jmsaavedra/gadgiteration/README.md

gadgiteration
=============

Hardware and firmware for the gadgiteration noisemaker v2.0

http://gadgiteration.org
