jmsaavedra/gadgiteration/v4.0/README.md

gadgIteration hardware v3.0
=============

ATmega32u4 Implementation of the Noisemaker!

###digital pinouts###

* D2 - Mode Button
* D5 - on-board LEDs. HIGH/LOW to flip LED1/LED2
* D6 - Neopixel Connection
* D7 - Range Button
* D8 - Audio out. NPN amplifier to speaker.

###analog pinouts###

* A0 - Standard Alligator In
* A1 - Human Circuit In
* A2 - SENSOR 1. 10k pull-down.
* A3 - SENSOR 2. 10k pull-down.
* A4 - SENSOR 3. VCC - SENS - GND.

###known bugs###
