jmsaavedra/gadgiteration/v4.0/eagle/noisemaker_4-0_BOM.xlsx

Part | Value | Link | Device | Package | Description | PROD_ID | VALUE
ATMEGA32U4 | ATMEGA32U4 | http://www.mouser.com/Search/ProductDetail.aspx | ATMEGA32U4TQFP | SPARKFUN-DIGITALIC_TQFP44 | Atmel 44-pin 8-bit Microcontroller with 32KBytes of ISP Flash and USB Controller | https://www.sparkfun.com/products/11181
POLE1 | alligator clip holes | https://www.adafruit.com/products/321 | M01ALLIGATOR-3MM | 1X01_ALLIGATOR_3MM | Header 1
LED1 | WS2812B3535 | http://www.mouser.com/ProductDetail/Seeed-Studio/110990053/?qs=sGAEpiMZZMtzPgOfznR9QTO1l8g3oIgjmGvsDAmgJrQ%3d | WS2812B3535 | LED3535 |  | https://www.adafruit.com/products/1655
C1, C3 | 0.1uF | http://www.mouser.com/ProductDetail/Vishay-Vitramon/VJ1206Y104KXJPW1BC/ | CAP1206 | 1206 | Capacitor
C2, C4 | 22pF | http://www.mouser.com/ProductDetail/Vishay-Vitramon/VJ0603A220JXACW1BC/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 | CAP0603-CAP | 0603-CAP | Capacitor
C5, C6, C9 | 1uF | https://www.mouser.com/Search/ProductDetail.aspx | CAP1206 | 1206 | Capacitor
C7, C8 | 10uF | http://www.mouser.com/Search/ProductDetail.aspx | CAP_POL3528-KIT | EIA3528-KIT | Capacitor Polarized
D4 |  | http://www.mouser.com/ProductDetail/Vishay-Semiconductors/BAS16WS-E3-08/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 | DIODESOD | SOD-323 | Diode
F1 | 500mA | https://www.mouser.com/Search/ProductDetail.aspx | PTCSMD | PTC-1206 | Resettable Fuse PTC
NPN |  | https://www.mouser.com/Search/ProductDetail.aspx | TRANSISTOR_NPNSOT23-3 | SOT23-3 | Generic NPN BJT. MMBT2222 is the common NPN we use. Double check against datasheet- not all devices are the same!
PWR | Red LED | http://www.mouser.com/ProductDetail/Kingbright/APT3216EC/?qs=sGAEpiMZZMseGfSY3csMkeytxqHAv00AIWduoh668qk%3d | LEDCHIPLED_1206 | CHIPLED_1206 | LED
PWRJACK | 2.1MMJACKTHM | https://www.mouser.com/Search/ProductDetail.aspx | 2.1MMJACKTHM | PJ-102A | 2.1mm x 5.5mm THM DC jack with internal switch. Digikey part #PJ-102A, 4UCON part #05537
R1, R11 | 1K | https://www.mouser.com/Search/ProductDetail.aspx | RESISTOR1206 | 1206 | Resistor
R2, R10, R13, R14 | 10K | https://www.mouser.com/Search/ProductDetail.aspx | RESISTOR1206 | 1206 | Resistor
R3, R8 | 1M | https://www.mouser.com/Search/ProductDetail.aspx | RESISTOR1206 | 1206 | Resistor
R4, R5 | 22 | https://www.mouser.com/Search/ProductDetail.aspx | RESISTOR1206 | 1206 | Resistor
R6, R7 | 330 | https://www.mouser.com/Search/ProductDetail.aspx | RESISTOR1206 | 1206 | Resistor
R9 | 22k | https://www.mouser.com/Search/ProductDetail.aspx | RESISTOR1206 | 1206 | Resistor
R12 | 2M | https://www.mouser.com/Search/ProductDetail.aspx | RESISTOR1206 | 1206 | Resistor
RX | Green LED | http://www.mouser.com/ProductDetail/OSRAM-Opto-Semiconductors/LG-N971-KN-1/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 | LEDCHIPLED_1206 | CHIPLED_1206 | LED
TX | Yellow LED | https://www.mouser.com/Search/ProductDetail.aspx | LEDCHIPLED_1206 | CHIPLED_1206 | LED
USB | USB-CON-5PIN-105017-0001 | http://www.mouser.com/ProductDetail/Molex/105017-0001/?qs=hlXxxvYE36k7QcsR97GUKA%3D%3D | USB-CON-5PIN-105017-0001 | USB-MICRO-MOLEX-105017-0001 | Molex Micro USB 105017-0001
MODE | MODE BUTTON | https://www.mouser.com/Search/ProductDetail.aspx | 10-XX | B3F-10XX | OMRON SWITCH
VOL | VOLUME POTENTIOMETER | https://www.mouser.com/Search/ProductDetail.aspx | POT | ALPS_POT |  | RES-09177
VREG | MIC5219 5V | http://www.mouser.com/ProductDetail/Microchip-Technology-Micrel/MIC5219-50YM5-TR/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 | V_REG_MIC52195V | SOT23-5 | V_REG MIC5219 | VREG-10107 | MIC5219 5V
XTAL | 16MHz | https://www.mouser.com/Search/ProductDetail.aspx | CRYSTAL5X3 | CRYSTAL-SMD-5X3 | Crystals
