jmsaavedra/gadgiteration/v4.0/eagle/noisemaker_4-0.pdf

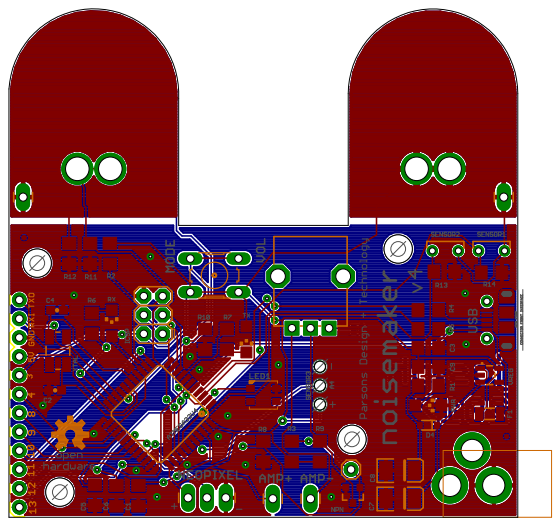
[picture p1: page 1]
