jmsaavedra/gadgiteration/v5.0/eagle/noisemaker_5-0.brd

## EAGLE design v5.0/eagle/noisemaker_5-0.brd (2017-06-26)

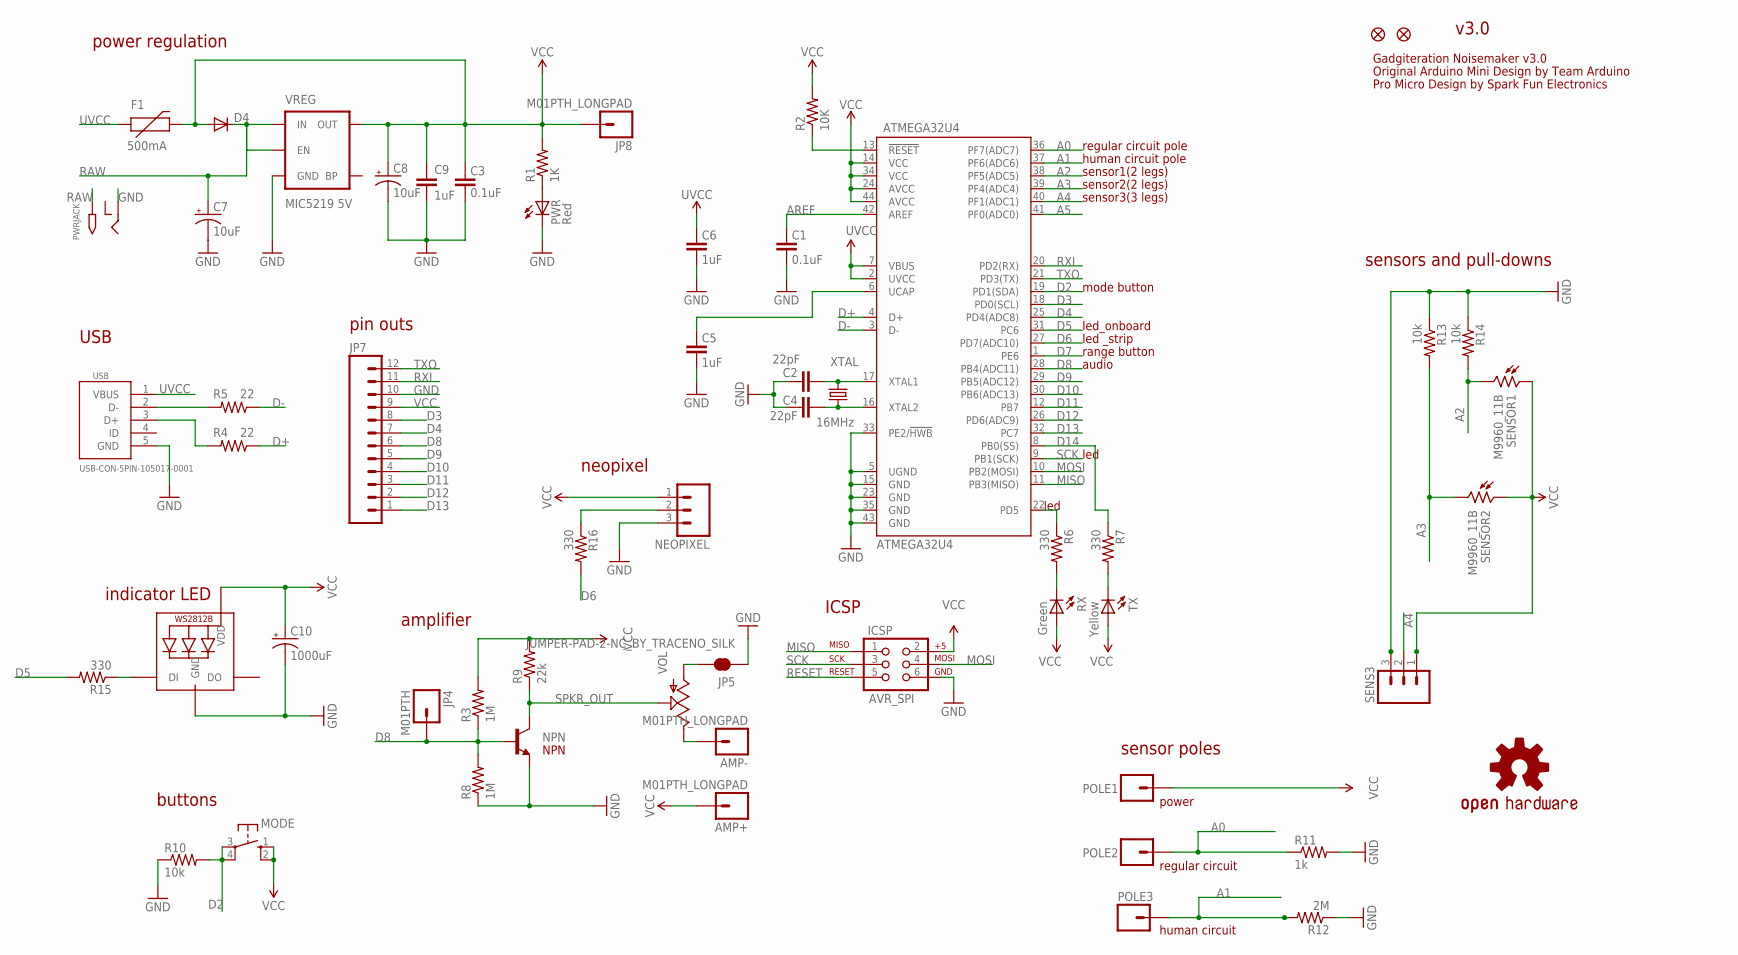
[picture p2: schematic noisemaker_5-0.sch]

Parts:
AMP+: M01PTH_LONGPAD; 1X01_LONGPAD
AMP-: M01PTH_LONGPAD; 1X01_LONGPAD
ATMEGA32U4: ATMEGA32U4; SPARKFUN-DIGITALIC_TQFP44
C1, C3: 0.1uF; 1206
C2, C4: 22pF; 0603-CAP
C5, C6, C9: 1uF; 1206
C7, C8: 10uF; EIA3528-KIT
C10: 1000uF; EIA3528-KIT
D4: DIODESOD; SOD-323
F1: 500mA; PTC-1206
ICSP: AVR_SPI; 2X3
JP1, JP2: FIDUCIALUFIDUCIAL; MICRO-FIDUCIAL
JP4: M01PTH; 1X01
JP5: JUMPER-PAD-2-NC_BY_TRACENO_SILK; PAD-JUMPER-2-NC_BY_TRACE_NO_SILK
JP7: M12PTH; 1X12
JP8: M01PTH_LONGPAD; 1X01_LONGPAD
LED1: WS2812B3535; LED3535
LOGO1: OSHW-LOGOM; OSHW-LOGO-M
MODE: 10-XX; B3F-10XX
NEOPIXEL: M03LONGPADS; 1X03_LONGPADS
NPN: TRANSISTOR_NPNSOT23-3; SOT23-3
POLE1, POLE2: M01ALLIGATOR-3MM; 1X01_ALLIGATOR_3MM
POLE3: M01PTH_LONGPAD; 1X01_LONGPAD
PWR: Red; CHIPLED_1206
PWRJACK: 2.1MMJACKTHM; PJ-102A
R1: 1K; 1206
R2: 10K; 1206
R3, R8: 1M; 1206
R4, R5: 22; 1206
R6, R7, R15, R16: 330; 1206
R9: 22k; 1206
R10, R13, R14: 10k; 1206
R11: 1k; 1206
R12: 2M; 1206
RX: Green; CHIPLED_1206
SENS3: M03POGO_PIN_HOLES_ONLY; 1X03_PP_HOLES_ONLY
SENSOR1, SENSOR2: M9960_11B; M9960
TX: Yellow; CHIPLED_1206
USB: USB-CON-5PIN-105017-0001; USB-MICRO-MOLEX-105017-0001
VOL: POT; ALPS_POT
VREG: MIC5219 5V; SOT23-5
XTAL: 16MHz; CRYSTAL-SMD-5X3

Connections:
A0: ATMEGA32U4.36 (PF7(ADC7)), POLE2.1@0, POLE2.1@2, R11.1
A1: ATMEGA32U4.37 (PF6(ADC6)), POLE3.1, R12.2
A2: ATMEGA32U4.38 (PF5(ADC5)), R14.2, SENSOR1.2
A3: ATMEGA32U4.39 (PF4(ADC4)), R13.2, SENSOR2.2
A4: ATMEGA32U4.40 (PF1(ADC1)), SENS3.2
A5: ATMEGA32U4.41 (PF0(ADC0))
AREF: ATMEGA32U4.42 (AREF), C1.2
D2: ATMEGA32U4.19 (PD1(SDA)), MODE.3, MODE.4 (P1), R10.2
D3: ATMEGA32U4.18 (PD0(SCL)), JP7.8
D4: ATMEGA32U4.25 (PD4(ADC8)), JP7.7
D5: ATMEGA32U4.31 (PC6), R15.2
D6: ATMEGA32U4.27 (PD7(ADC10)), R16.2
D7: ATMEGA32U4.1 (PE6)
D8: ATMEGA32U4.28 (PB4(ADC11)), JP4.1, JP7.6, NPN.1 (B), R3.1, R8.2
D9: ATMEGA32U4.29 (PB5(ADC12)), JP7.5
D10: ATMEGA32U4.30 (PB6(ADC13)), JP7.4
D11: ATMEGA32U4.12 (PB7), JP7.3
D12: ATMEGA32U4.26 (PD6(ADC9)), JP7.2
D13: ATMEGA32U4.32 (PC7), JP7.1
D14: ATMEGA32U4.8 (PB0(SS)), R7.1
D+: ATMEGA32U4.4 (D+), R4.1
D-: ATMEGA32U4.3 (D-), R5.1
GND: ATMEGA32U4.5 (UGND), ATMEGA32U4.15 (GND), ATMEGA32U4.23 (GND), ATMEGA32U4.33 (PE2/!HWB), ATMEGA32U4.35 (GND), ATMEGA32U4.43 (GND), C1.1, C2.2, C3.1, C4.2, C5.1, C6.1, C7.C (-), C8.C (-), C9.2, C10.C (-), ICSP.6, JP5.1, JP7.10, LED1.4 (GND), NEOPIXEL.3, NPN.2 (E), PWR.C, PWRJACK.RING, R8.1, R10.1, R11.2, R12.1, R13.1, R14.1, SENS3.3, USB.5 (GND), VREG.2 (GND)
MISO: ATMEGA32U4.11 (PB3(MISO)), ICSP.1
MOSI: ATMEGA32U4.10 (PB2(MOSI)), ICSP.4
unnamed: ATMEGA32U4.16 (XTAL2), C4.1, XTAL.1
unnamed: ATMEGA32U4.17 (XTAL1), C2.1, XTAL.3 (2)
unnamed: AMP-.1, VOL.P$1 (E)
unnamed: ATMEGA32U4.6 (UCAP), C5.2
unnamed: R7.2, TX.C
unnamed: JP5.2, VOL.P$3 (A)
unnamed: R6.2, RX.C
unnamed: LED1.1 (DI), R15.1
unnamed: NEOPIXEL.2, R16.1
unnamed: PWR.A, R1.1
unnamed: R4.2, USB.3 (D+)
unnamed: R5.2, USB.2 (D-)
RAW: C7.A (+), D4.1 (C), PWRJACK.TIP, VREG.1 (IN), VREG.3 (EN)
RESET: ATMEGA32U4.13 (!RESET), ICSP.5, R2.1
RXI: ATMEGA32U4.20 (PD2(RX)), JP7.11
SCK: ATMEGA32U4.9 (PB1(SCK)), ICSP.3
SPKR_OUT: NPN.3 (C), R9.1, VOL.P$2 (S)
TXLED: ATMEGA32U4.22 (PD5), R6.1
TXO: ATMEGA32U4.21 (PD3(TX)), JP7.12
UVCC: ATMEGA32U4.2 (UVCC), ATMEGA32U4.7 (VBUS), C6.2, F1.1, USB.1 (VBUS)
VCC: AMP+.1, ATMEGA32U4.14 (VCC), ATMEGA32U4.24 (AVCC), ATMEGA32U4.34 (VCC), ATMEGA32U4.44 (AVCC), C3.2, C8.A (+), C9.1, C10.A (+), D4.2 (A), F1.2, ICSP.2, JP7.9, JP8.1, LED1.2 (VDD), MODE.1 (S), MODE.2 (S1), NEOPIXEL.1, POLE1.1@0, POLE1.1@2, R1.2, R2.2, R3.2, R9.2, RX.A, SENS3.1, SENSOR1.1, SENSOR2.1, TX.A, VREG.5 (OUT)

Notes on the sheet:
Original Arduino Mini Design by Team Arduino
Pro Micro Design by Spark Fun Electronics
v3.0
power regulation
pin outs
USB
NPN
amplifier
sensors and pull-downs
ICSP
buttons
sensor poles
human circuit
regular circuit
power
Gadgiteration Noisemaker v3.0
sensor3(3 legs)
sensor1(2 legs)
sensor2(2 legs)
human circuit pole
regular circuit pole
mode button
range button
audio
led_onboard
led
led _strip
neopixel
indicator LED

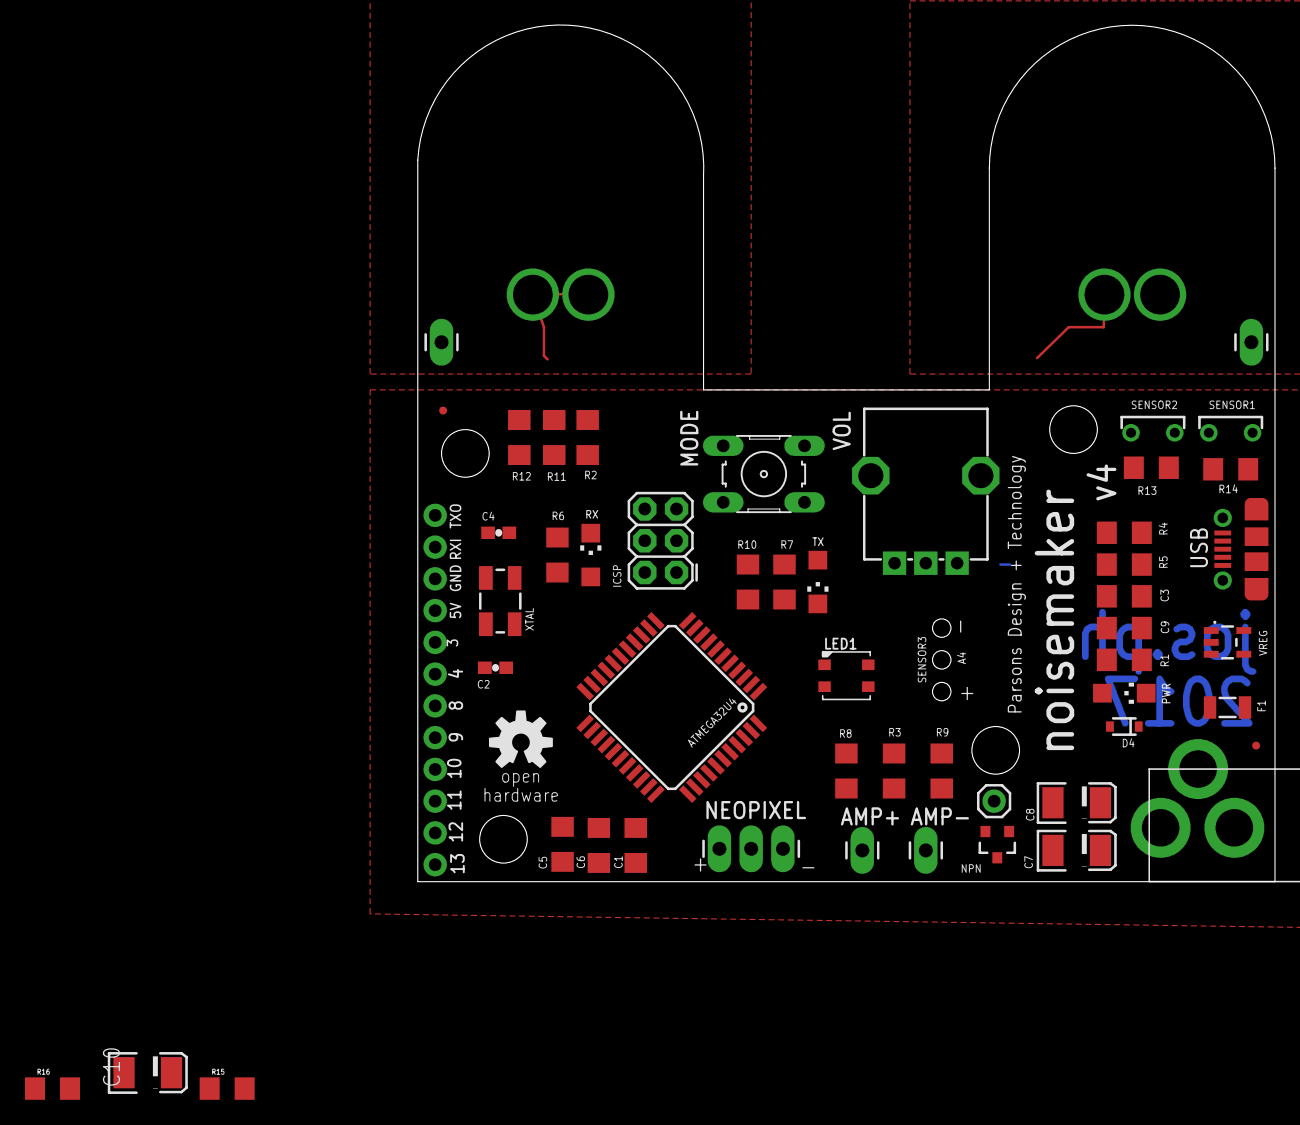
[picture p3: board noisemaker_5-0.brd from above]

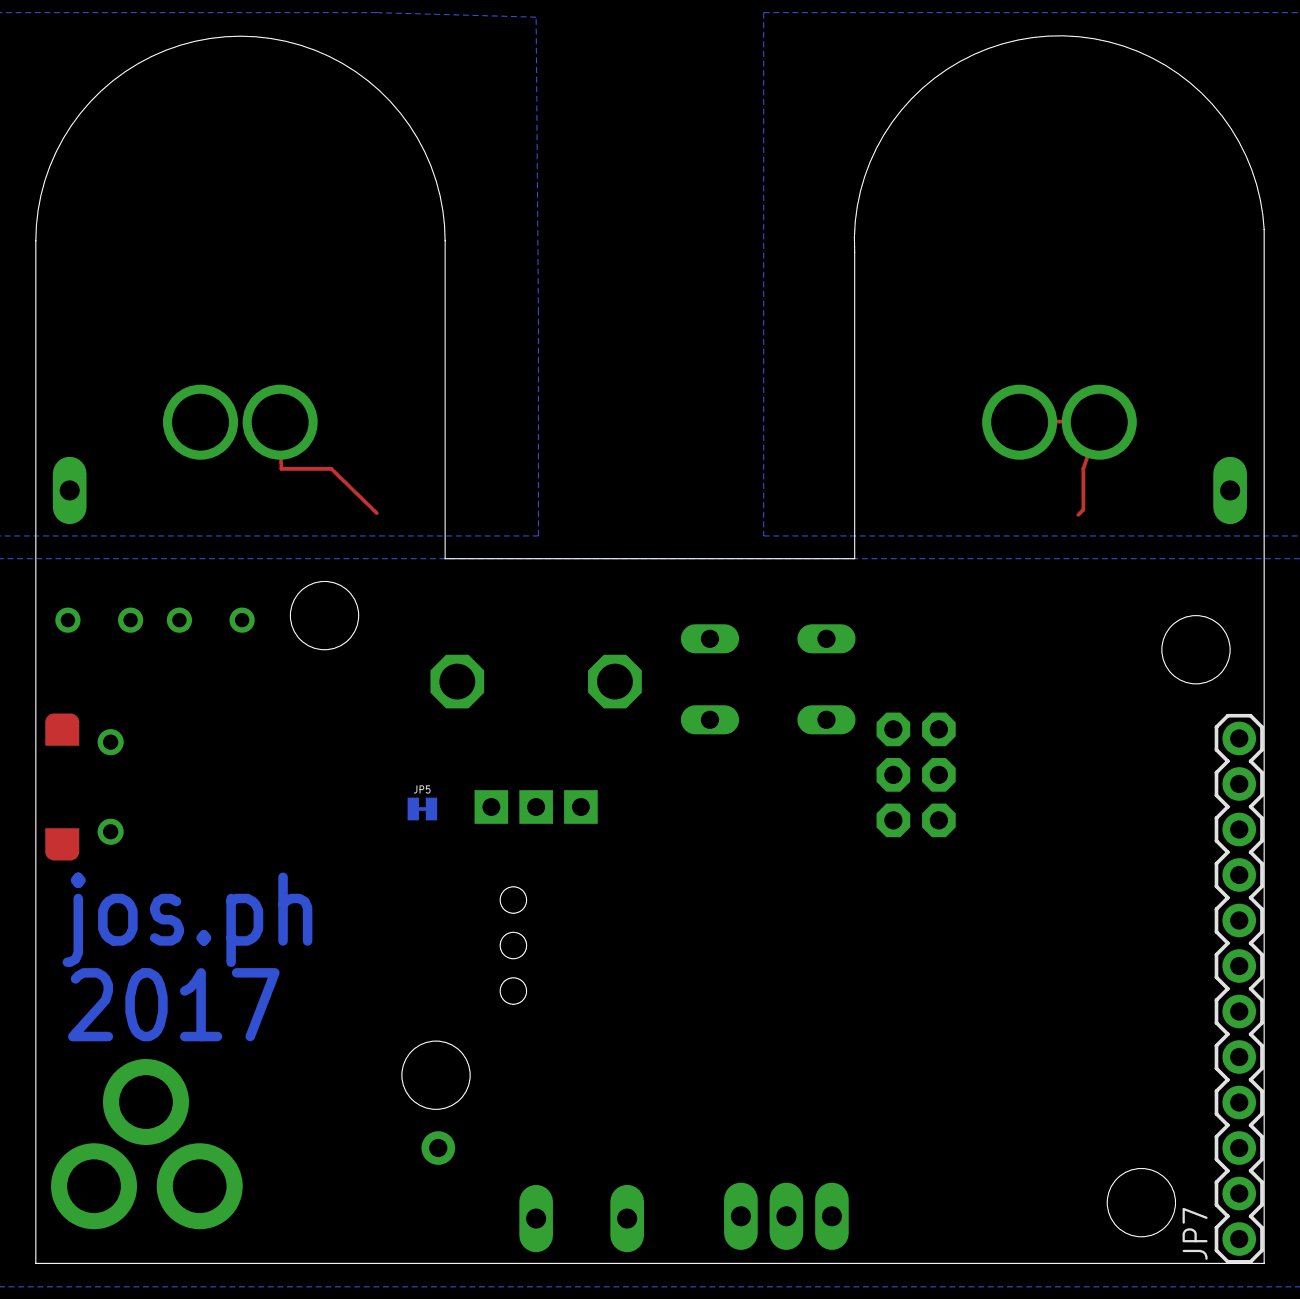
[picture p4: board noisemaker_5-0.brd from below]

Board: 2 copper layers, 68.6 x 68.5 mm, 57 parts (2 on the bottom side), 44 nets.
