jmsaavedra/gadgiteration/v2.0/eagle/gadgiteration_v20.brd

## EAGLE design v2.0/eagle/gadgiteration_v20.brd (2013-07-01, an earlier design)

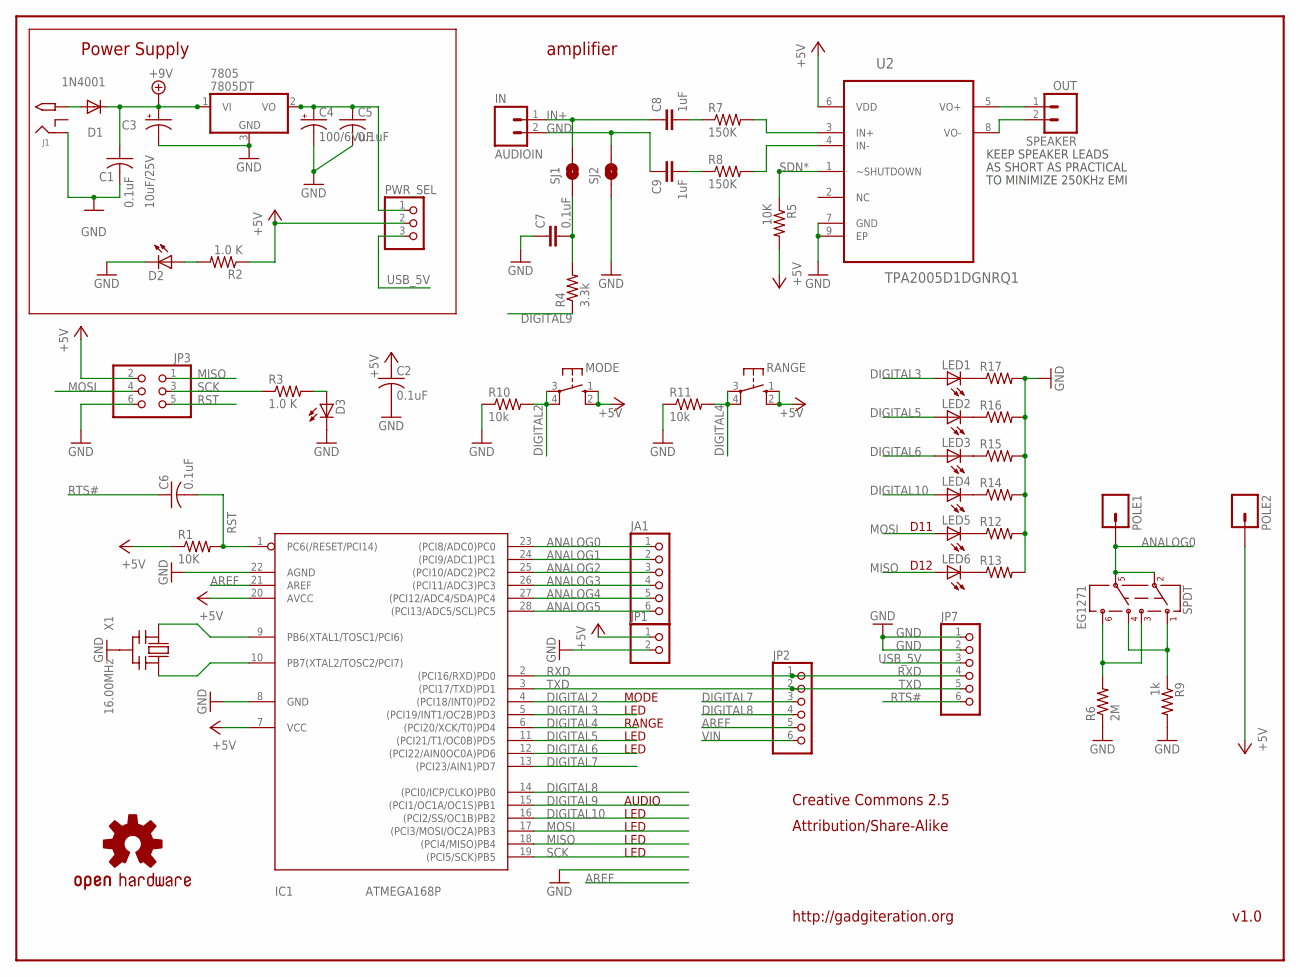
[picture p5: schematic gadgiteration_v20.sch]

Parts:
7805: 7805DT; TO252
AUDIOIN: IN; 1X02
C1, C2, C5, C6: 0.1uF; C025-025X050
C3: 10uF/25V; E2,5-6
C4: 100/6VuF; E2,5-6
C7: 0.1uF; CAP-PTH-SMALL-KIT
C8, C9: 1uF; 1206
D1: 1N4001; DIODE-1N4001
D2: LED3MM
D3: Green; LED3MM
IC1: ATMEGA168P; DIL28/3
J1: 2.1MMJACK; PJ-102A
JA1: PINHD-1X6CB; 1X06-CLEANBIG
JP1: PINHD-1X2CB; 1X02-CB
JP2: PINHD-1X6CB; 1X06-CLEANBIG
JP3: PINHD-2X3; 2X03
JP7: PINHD-1X6CLEAN; 1X06-CLEAN
LED1, LED2, LED3, LED4, LED5, LED6: LEDCHIPLED_1206; CHIPLED_1206
LOGO1: OSHW-LOGOM; OSHW-LOGO-M
MODE: 10-XX; B3F-10XX
POLE1, POLE2: M01PTH_LONGPAD; 1X01_LONGPAD
PWR_SEL: PINHD-1X3; 1X03
R1: 10K; 0207/5V
R2, R3: 1.0 K; 0207/5V
R4: 3.3k; M1206
R5: 10K; 0204/5
R6: 2M; 0204/5
R7, R8: 150K; 0204/5
R9: 1k; 0204/5
R10, R11: 10k; R1206
R12, R13, R14, R15, R16, R17: R-US_M0805; M0805
RANGE: 10-XX; B3F-10XX
SJ1, SJ2: SOLDERJUMPERTRACE; SJ_2S-TRACE
SPEAKER: OUT; 1X02_LONGPADS
U2: TPA2005D1DGNRQ1; SOP65P490X110-9N
U$1: AYZ0202; EG1271
X1: 16.00MHz; CERM_OSC

Connections:
+5V: C2.1, IC1.7 (VCC), IC1.20 (AVCC), JP1.1, JP3.2, MODE.1 (S), MODE.2 (S1), POLE2.1, PWR_SEL.2, R1.1, R2.1, R5.2, RANGE.1 (S), RANGE.2 (S1), U2.6 (VDD)
ANALOG0: IC1.23 ((PCI8/ADC0)PC0), JA1.1, POLE1.1, U$1.P$3 (5), U$1.P$4 (2)
ANALOG1: IC1.24 ((PCI9/ADC1)PC1), JA1.2
ANALOG2: IC1.25 ((PCI10/ADC2)PC2), JA1.3
ANALOG3: IC1.26 ((PCI11/ADC3)PC3), JA1.4
ANALOG4: IC1.27 ((PCI12/ADC4/SDA)PC4), JA1.5
ANALOG5: IC1.28 ((PCI13/ADC5/SCL)PC5), JA1.6
AREF: IC1.21 (AREF), JP2.5
DIGITAL2: IC1.4 ((PCI18/INT0)PD2), MODE.3, MODE.4 (P1), R10.2
DIGITAL3: IC1.5 ((PCI19/INT1/OC2B)PD3), LED1.A
DIGITAL4: IC1.6 ((PCI20/XCK/T0)PD4), R11.2, RANGE.3, RANGE.4 (P1)
DIGITAL5: IC1.11 ((PCI21/T1/OC0B)PD5), LED2.A
DIGITAL6: IC1.12 ((PCI22/AIN0OC0A)PD6), LED3.A
DIGITAL7: IC1.13 ((PCI23/AIN1)PD7), JP2.3
DIGITAL8: IC1.14 ((PCI0/ICP/CLKO)PB0), JP2.4
DIGITAL9: IC1.15 ((PCI1/OC1A/OC1S)PB1), R4.1
DIGITAL10: IC1.16 ((PCI2/SS/OC1B)PB2), LED4.A
GND: 7805.3 (GND), AUDIOIN.2, C1.2, C2.2, C3.-, C4.-, C5.2, C7.1, C9.1, D2.K (C), D3.K (C), IC1.8 (GND), IC1.22 (AGND), J1.RING, JP1.2, JP3.6, JP7.1, JP7.2, R6.1, R9.2, R10.1, R11.1, R12.2, R13.2, R14.2, R15.2, R16.2, R17.2, SJ2.1, SJ2.2, U2.7 (GND), U2.9 (EP), X1.P$2 (GND)
IN+: AUDIOIN.1, C8.1, SJ1.2
IN+AMP: R7.2, U2.3 (IN+)
IN+_: C7.2, R4.2, SJ1.1
IN-AMP: R8.2, U2.4 (IN-)
MISO: IC1.18 ((PCI4/MISO)PB4), JP3.1, LED6.A
MOSI: IC1.17 ((PCI3/MOSI/OC2A)PB3), JP3.4, LED5.A
unnamed: IC1.9 (PB6(XTAL1/TOSC1/PCI6)), X1.P$1 (IN)
unnamed: IC1.10 (PB7(XTAL2/TOSC2/PCI7)), X1.P$3 (OUT)
unnamed: D2.A, R2.2
unnamed: D3.A, R3.2
unnamed: LED5.C, R12.1
unnamed: C8.2, R7.1
unnamed: C9.2, R8.1
unnamed: R6.2, U$1.P$5 (3), U$1.P$6 (6)
unnamed: R9.1, U$1.P$1 (1), U$1.P$2 (4)
unnamed: LED6.C, R13.1
unnamed: LED4.C, R14.1
unnamed: LED3.C, R15.1
unnamed: LED2.C, R16.1
unnamed: LED1.C, R17.1
unnamed: D1.A, J1.TIP
unnamed: SPEAKER.1, U2.5 (VO+)
unnamed: SPEAKER.2, U2.8 (VO-)
unnamed: 7805.2 (VO), C4.+, C5.1, PWR_SEL.1
RST: C6.2, IC1.1 (PC6(/RESET/PCI14)), JP3.5, R1.2
RTS#: C6.1, JP7.6
RXD: IC1.2 ((PCI16/RXD)PD0), JP2.1, JP7.4
SCK: IC1.19 ((PCI5/SCK)PB5), JP3.3, R3.1
SDN*: R5.1, U2.1 (~SHUTDOWN)
TXD: IC1.3 ((PCI17/TXD)PD1), JP2.2, JP7.5
USB_5V: JP7.3, PWR_SEL.3
VIN: 7805.1 (VI), C1.1, C3.+, D1.C, JP2.6

Notes on the sheet:
Power Supply
v1.0
http://gadgiteration.org
Creative Commons 2.5
Attribution/Share-Alike
KEEP SPEAKER LEADS
AS SHORT AS PRACTICAL
TO MINIMIZE 250KHz EMI
amplifier
D12
LED
D11
AUDIO
MODE
RANGE

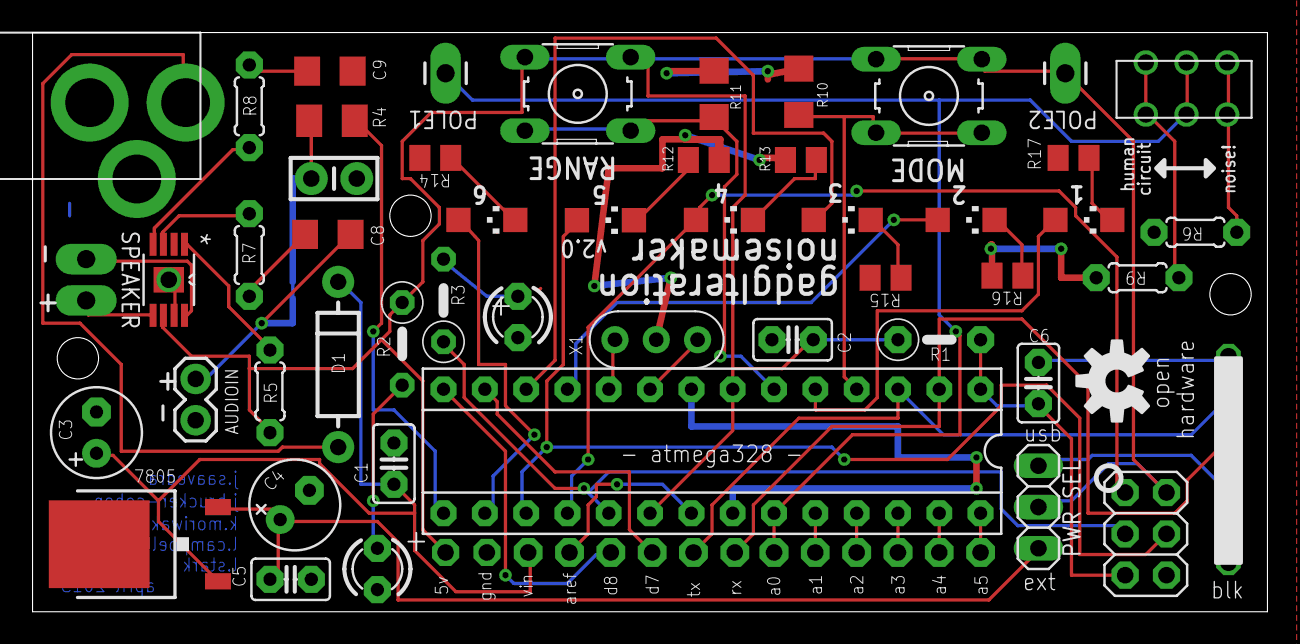
[picture p6: board gadgiteration_v20.brd from above]

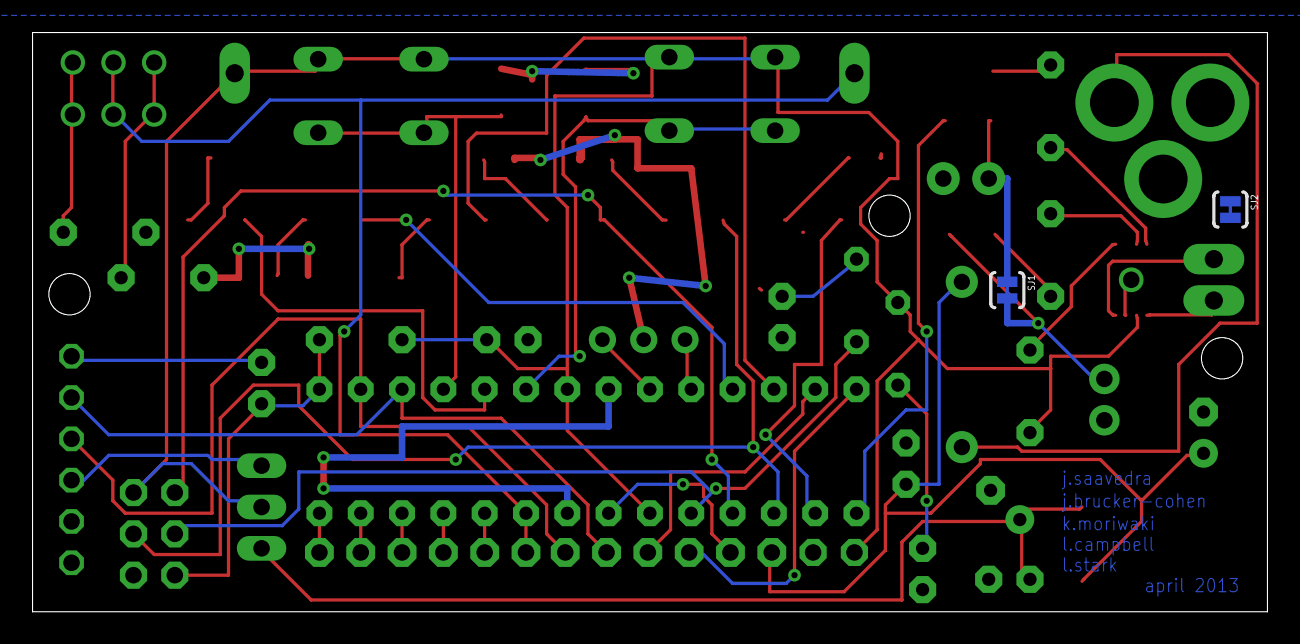
[picture p7: board gadgiteration_v20.brd from below]

Board: 2 copper layers, 75.9 x 35.6 mm, 56 parts (2 on the bottom side), 50 nets.
