jmsaavedra/gadgiteration/(commit log)

2013-07-01 added eagle schematic and board, arduino firmware
    [gadgiteration_v21.brd, gadgiteration_v21.sch]
2014-02-24 added v21 files, including readme and eagle files
    [gadgiteration_v20.brd, gadgiteration_v20.sch, gadgiteration_v21.sch]
2014-02-24 refactored repository folder structure
    [gadgiteration_v20.brd, gadgiteration_v20.sch, gadgiteration_v21.brd, gadgiteration_v21.sch]
2014-02-24 added buttonTest01
2014-02-24 updated _03 LED STRIP sketch, still in progress
2014-02-24 added arduino folder to v2.1
2014-02-24 updated 2.1 readme known bugs
    [_03_buttonModeLedStrip.ino, neopixels.ino]
2014-04-10 adding bcal arduino code - havent changed the button mode
2014-04-24 code for one button
2014-05-04 updated led strip examples
2014-05-04 board 3.0
    [noisemaker_3-0.brd, noisemaker_3-0.sch]
2014-05-04 updating with gitignore
    [gadgiteration_v20.brd, gadgiteration_v20.sch, gadgiteration_v21.brd, gadgiteration_v21.sch, noisemaker_3-0.brd, noisemaker_3-0.sch]
2014-05-04 updated with gitignore implemented
    [gadgiteration_v20.brd, gadgiteration_v20.sch, gadgiteration_v21.brd, gadgiteration_v21.sch, noisemaker_3-0.brd, noisemaker_3-0.sch]
2014-05-04 updated board, schematic comments
    [noisemaker_3-0.brd, noisemaker_3-0.sch]
2014-05-04 updated readme, folder structure
    [noisemaker_3-0.brd, noisemaker_3-0.sch]
2014-05-05 board updates...
    [noisemaker_3-0.brd, noisemaker_3-0.sch]
2014-05-06 updated board layout
    [noisemaker_3-0.brd, noisemaker_3-0.sch]
2014-05-06 updated board layout tues
    [noisemaker_3-0.brd, noisemaker_3-0.sch]
2014-05-07 merging in @shanqiu's latest updates
    [noisemaker_3-0.brd, noisemaker_3-0.sch]
2014-05-07 board file
    text has been updated, layout is completed. needs logos, names, more text love.
    [noisemaker_3-0.brd, noisemaker_3-0.sch]
2014-05-08 board layout, all text complete. ready for manufacture, RC1
    [noisemaker_3-0.brd, noisemaker_3-0.sch]
2014-05-08 updated minor text in board file
    [noisemaker_3-0.brd]
2014-05-08 fixed critical outline error
    [noisemaker_3-0.brd]
2014-05-08 small adjustments, this is final board
    [noisemaker_3-0.brd, noisemaker_3-0.sch]
2014-05-09 adding gerber files
2014-05-09 added BOM.csv file
    [noisemaker_3-0_BOM.csv]
2014-05-27 updated BOM and PLIST files for quotes!
    [noisemaker_3-0_BOM.csv, noisemaker_3-0_PLIST.csv]
2014-05-28 updated voltage regulator, added second footprint for NPN options
    [noisemaker_3-0.brd, noisemaker_3-0.sch]
2014-05-28 upated BOM, Partslist, and gerber files
    [noisemaker_3-0_BOM.csv, noisemaker_3-0_PLIST.csv]
2017-03-04 added v4 with new vreg, volume pot, new eagle v
    [noisemaker_4-0.brd, noisemaker_4-0.sch]
2017-03-10 4.0 completed with gerber exports
    [noisemaker_4-0.brd, noisemaker_4-0.sch]
2017-03-13 added v4 BOM
    [noisemaker_4-0_BOM.xlsx]
2017-06-26 added arduino sketches for v4
2017-06-26 added v5 board updates
    [noisemaker_5-0.brd, noisemaker_5-0.sch]
